ellenlowing/woodpeckersPro/test/testArduinoCommunication/arduino1test/arduino1test.ino

#include <Wire.h>

void setup() {
  Wire.begin(); // join i2c bus (address optional for master)
}

byte x = 0;

void loop() {
  Wire.beginTransmission(8); // transmit to device #8
  int x = 1;
  Wire.write(x);             // sends one byte
  Wire.endTransmission();    // stop transmitting
  delay(500);
}
