ellenlowing/woodpeckersPro/(commit log)

2017-04-19 Added test for ultrasonic sensor
2017-04-24 added main code and test for sensor lib
2017-04-25 testing connections between Arduino
2017-04-26 Add test that shows voltage of battery
2017-04-26 Added voltage sensing and notify owner in main
2017-04-26 added main code for 2nd arduino
2017-04-29 Add circuit
2017-04-29 Add circuit to README
2017-04-29 Modify circuit and README
2017-05-04 add images of prototype appearance
2017-05-04 Add pictures of prototype design
